linchangyi1/LocoMan/source/LocoMan_appendix.pdf

APPENDIX

A. Joint Limits of Loco-Manipulator
The range of motion for loco-manipulator’s joints is illustrated in Fig. 12, with angles of 280°, 210°, and 360° for the first through the final joint, respectively.
The motion limitation of the first joint arises from a collision between the first servo and the support structure that is part of the outer calf connector (Fig. 2). This support structure is designed primarily to connect to the opposite horn of the first servo, playing a vital role in stabilizing the manipulator. The design of the support structure aims to minimize its impact on the essential range of motion of the first servo. This critical range is necessary for extending the gripper during transitions from locomotion to manipulation and for positioning the gripper forwards and towards the ground, representing the primary workspace. The limitations in the motion of the second joint are due to self-collision. For the third joint, it does not face stringent motion restrictions, except for those imposed by the cable’s length.

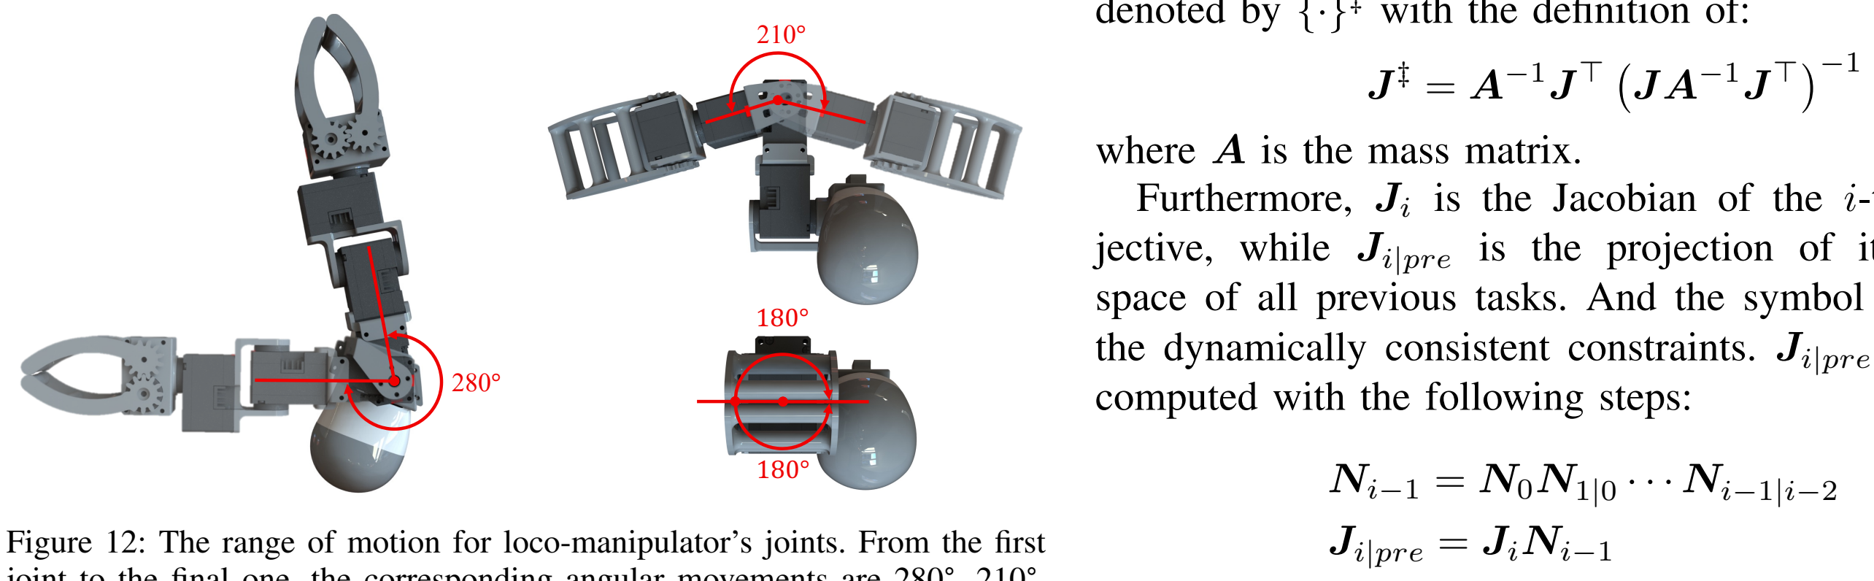
[picture p8: figure]
where A is the mass matrix. Furthermore, Ji; computed with the following steps:; Ji|pre = JiNi−1

Figure 12: The range of motion for loco-manipulator’s joints. From the first joint to the final one, the corresponding angular movements are 280°, 210°, and 360° respectively.

B. Whole-Body Impulse Control
Notation from IV: robot state q = (x

torso
, qj ) ∈ R

24, where
x

torso ∈ R

6 denotes the position and orientation of the floating torso, and qj ∈ R

18 denotes the joint angles of LocoMan. The bar notation (·) denotes all desired states.
1) Hierarchical Objective Tracking: As depicted in Table III, there are n tracking objectives in different operation modes, comprising n tracking tasks to be executed. The null space projection technique is utilized to track each objective in hierarchical order (from 1-st to n-th).
In the i-th (i = 1, ..., n) task, the tracking items consist of the desired position xi

, velocity x˙ i

, and acceleration x¨i of
the i-th tracking objective, which are tracked by computing the desired position qi

, velocity q˙
i

, and acceleration q¨i
for
both the floating torso and the joints. The desired states (qn, q˙n, and q¨n) for the last tracking objective would be the final desired states (q, q˙, and q¨) of LocoMan.

qi = qi−1 + Ji|pre

†
(xi − xi − Ji (qi−1 − q))

q˙i = q˙i−1 + Ji|pre

†
x˙ i − Jiq˙i−1

q¨i = J

dyn
i|pre

‡
x¨

cmd

i − J˙ iq˙ − Jiq¨i−1

(1)

The acceleration command x¨

cmd
i

is computed by:

x¨

cmd
i = x¨i + Kacc p

(xi − xi) + Kacc
d
x˙ i − x˙ i
(2)
where Kacc
p

and Kacc
| d

denote position and velocity feedback gains.
To compute the desired states of LocoMan from the tracking objective, we need to use the pseudo-inverse of the Jacobian. In Equation (1), we track the desired position and velocity kinematically, and the desired acceleration dynamically. Therefore, two types of pseudo-inverses are utilized. One is the SVD-based pseudo-inverse denoted by {·}†
, whcih is defined
as:
J = UΣV

T

J

† = V Σ†U
T

(3)

where J is the Jacobian and U and V are the orthogonal matrices. Besides, Σ is the diagonal matrix, and Σ†
is formed
by taking the reciprocal of each non-zero element on the diagonal of Σ, leaving the zeros in place, and then transposing the matrix.
The other is the dynamically consistent pseudo-inverse denoted by {·}‡ with the definition of:

(4)

is the Jacobian of the i-th tracking objective, while Ji|pre is the projection of it into the null space of all previous tasks. And the symbol {·}dyn denotes the dynamically consistent constraints. Ji|pre and J

dyn
i|pre

are

Ji|i−1 = Ji

I − Ji−1

†Ji−1

Ni|i−1 = I − Ji|i−1

†Ji|i−1

N

dyn
i−1 = N

dyn
0 N

dyn
| 1|0
- · · N

dyn
i−1|i−2
J

dyn

i|pre = JiN | dyn
| i−1
J

dyn
i|i−1 = Ji
I − Ji−1

‡Ji−1

N

dyn
i|i−1 = I − J
| dyn
| i|i−1

‡
J

dyn
i|i−1

(5)

where Ni−1, Ji|i−1, and Ni|i−1 represent the null space of the previous (i − 1) tasks, the projection of the Jacobian Ji into the null space of the (i − 1)-th task, and the independent null space introduced by the i-th task.
Here, i is within the range of 1, ..., n. And the initial items are defined as:
N0 = I − Jc

†Jc

N

dyn
0 = I − Jc

‡Jc

J0 = Jc
q0 = q
q˙0 = 0

q¨0 = Jc

| ‡
| (−Jcq˙)

(6)

where Jc is the Jacobian of the feet in contact.

2) Quadratic Programming: With the desired acceleration q¨ computed in the previous step, we solve a Quadratic Program (QP) to optimize for ground reaction forces. The QP problem is formulated as:

min
fr,δt

f

⊤
r Q1fr + δ

⊤
t Q2δt | (7)

s.t. Sf (Aq¨

cmd + b + g) = SfJ

⊤
c

fr (floating torso dyn.)

q¨

cmd = q¨ +

δt
0j
(floating torso acceleration)
Wfr ≥ 0 | (contact force constraints)

where the optimization objective is to minimize the reaction force fr and the relaxation variable δt for the floating torso acceleration with the weights Q1 and Q2. Sf , A, b, g, and W are the floating torso selection matrix, the mass matrix, the Coriolis force, the gravitation force, and the force constraint matrix for foot contact, respectively.
With the optimized reaction force fr and relaxation variable δt for the floating torso acceleration, we compute the joint torque command with the multi-body dynamics formulation:
τt
τj
= Aq¨

cmd + b + g − J

⊤
c
fr | (8)

where τj is the torque command for LocoMan’s joints.
3) Joint-Level PD Control: We compute the desired position qj , velocity q˙j , and torque τj for LocoMan’s joints in the previous steps, which runs in 400Hz. The final torque command τj applied to each joint is computed by a joint-level PD controller that runs in 2000Hz:

τj = τj + Ktau
p

(qj − qi) + Ktau
d
q˙j − q˙i
(9)

The high frequency joint-level PD feedback enables the robot

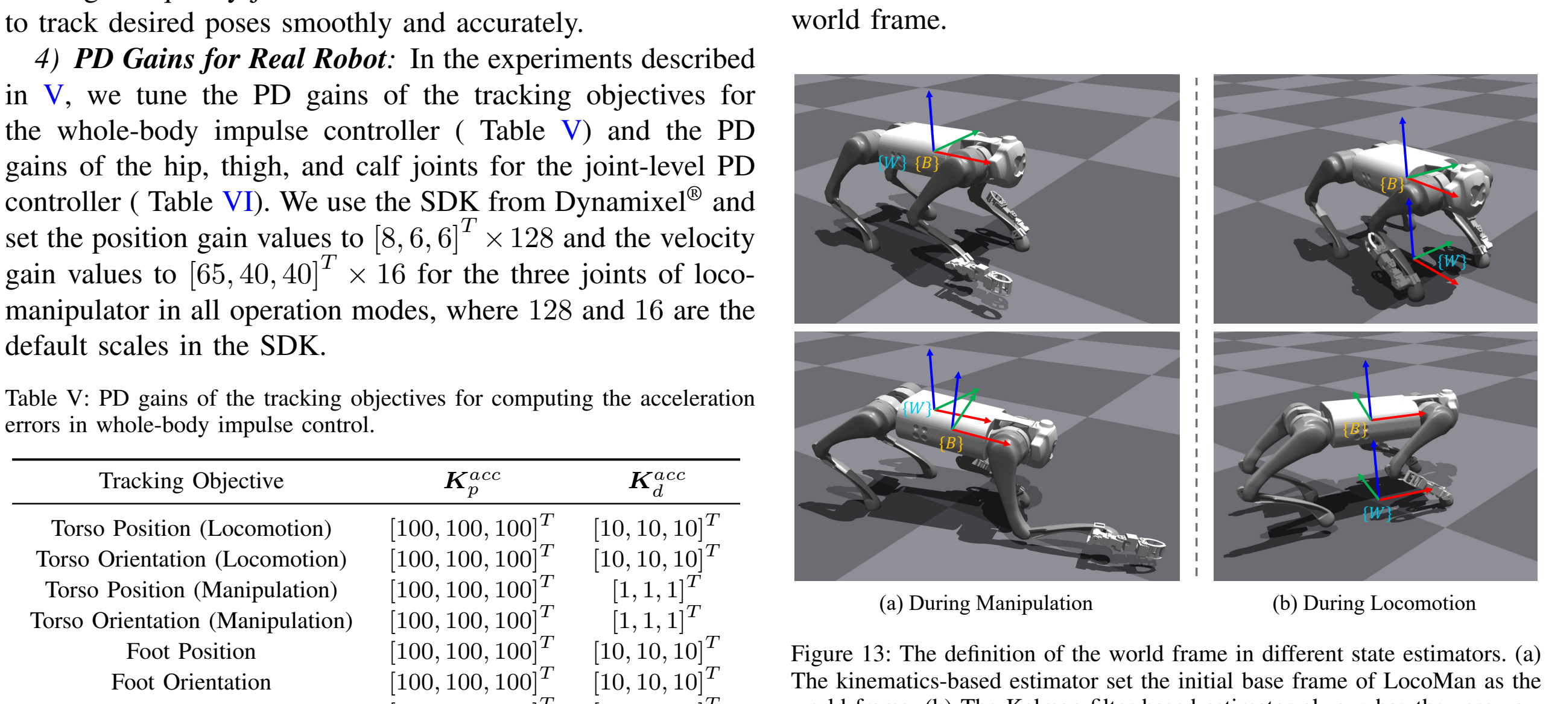
[picture p9: figure]
×128 and the velocity × 16 for the three joints of loco-; default scales in the SDK.; errors in whole-body impulse control.; Tracking Objective; Kacc; Torso Position (Locomotion); Torso Orientation (Locomotion); Torso Position (Manipulation); Torso Orientation (Manipulation); Foot Position; Foot Orientation; world frame.

to track desired poses smoothly and accurately.
4) PD Gains for Real Robot: In the experiments described in V, we tune the PD gains of the tracking objectives for the whole-body impulse controller ( Table V) and the PD gains of the hip, thigh, and calf joints for the joint-level PD controller ( Table VI). We use the SDK from Dynamixel® and set the position gain values to [8, 6, 6]T
gain values to [65, 40, 40]T
manipulator in all operation modes, where 128 and 16 are the

Table V: PD gains of the tracking objectives for computing the acceleration

Gripper Position | [100, 100, 100]T

[10, 10, 10]T
Gripper Orientation | [100, 100, 100]T

[10, 10, 10]T

Table VI: PD gains of the hip, thigh, and calf joints for computing the applied torque in joint-level PD control.

Leg Mode | Ktau
p | Ktau
d
Stance Legs in Locomotion | [30, 30, 30]T

[1, 1, 1]T
Swing Legs in Locomotion | [30, 30, 30]T

[1, 1, 1]T
Stance Legs in Loco-Manipulation [30, 30, 30]T

[1, 1, 1]T
Swing Legs in Loco-Manipulation [20, 20, 20]T

[0.8, 0.8, 0.8]T
Stance Legs in Single-Arm Manipulation [60, 60, 60]T

[2, 2, 2]T
Swing Legs in Single-Arm Manipulation [60, 60, 60]T

[2, 2, 2]T
Stance Legs in Bimanual Manipulation [100, 100, 100]T

[2.5, 2.5, 2.5]T
Swing Legs in Bimanual Manipulation [30, 30, 30]T

[1, 1, 1]T

C. State Estimation
As illustrated in Table III, there are two state estimators in our system, including the kinematics-based estimator used in the manipulation modes and the Kalman filter-based estimator used in the locomotion mode and the loco-manipulation mode. As depicted in Fig. 13 (a), at the moment when LocoMan finishes the transition process from other operation modes to manipulation modes, the kinematics-based estimator sets the base frame of LocoMan as the world frame. Furthermore, we also record the positions of the contact foot as P W
init,
which can be computed using forward kinematics and have the same values in the world frame or the base frame at the reset moment. During manipulation, the world frame remains fixed, and we compute the current positions of the contact foot in the base frame as P

B
cur. Assuming that there is no slip occurring between the contact foot and the ground, we employ the Procrustes analysis method to solve the transform matrix from the world frame to the base frame T

B
W .
As for locomotion, we implement the Kalman filter-based estimator which fuses the IMU information. As Fig. 13 (b) shows, the world frame is always updated to be the zero-yaw
(a) During Manipulation | (b) During Locomotion

Figure 13: The definition of the world frame in different state estimators. (a) The kinematics-based estimator set the initial base frame of LocoMan as the world frame. (b) The Kalman filter-based estimator always has the zero-yaw world frame as the world frame.
