linchangyi1/LocoMan/LocoMan_Hardware/assembly/loco-manipulator_right.SLDASM

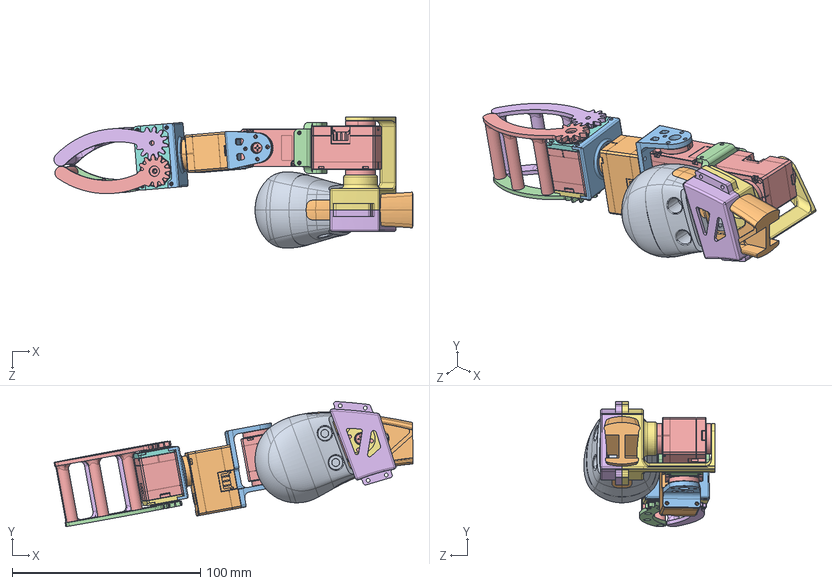
[picture p10: CAD file, 2024-10-17]
LocoMan_Hardware/assembly/loco-manipulator_right.SLDASM
190.7 x 66.4 x 69.8 mm
calf_connector_right_outside
calf_connector_right_inside
servo_double x 3
joint_connector_1
joint_connector_2
servo_single
bearing x 2
bearing_holder_1
bearing_holder_2
jaw_bearing
jaw_negative_horn
jaw_positive_horn
joint_connector_3
go1_calf_right
go1_foot_right
