linchangyi1/LocoMan/LocoMan_Hardware/Loco-Manipulators_URDF/loco_manipulator_left/loco_manipulator_left.SLDASM

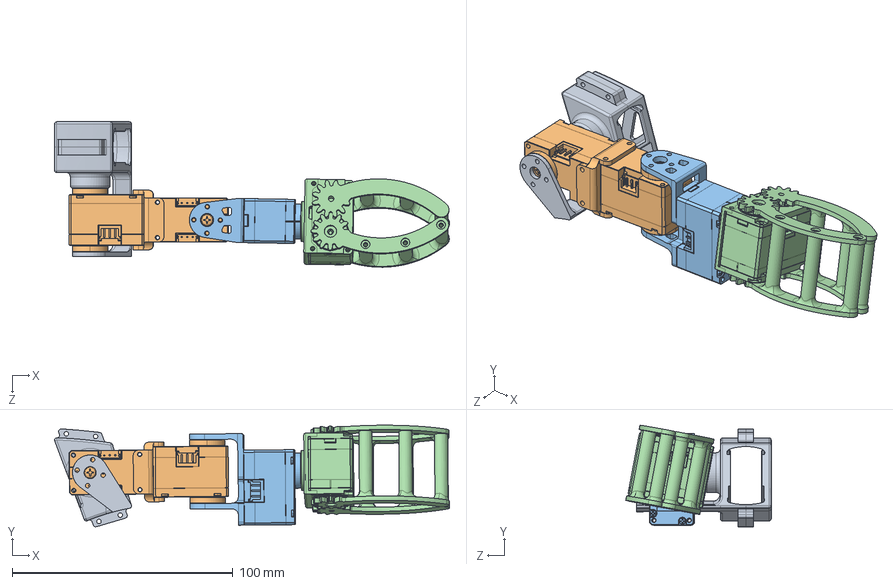
[picture p11: CAD file, 2024-10-17]
LocoMan_Hardware/Loco-Manipulators_URDF/loco_manipulator_left/loco_manipulator_left.SLDASM
178.9 x 46.0 x 65.9 mm
left_link_1
left_link_2
left_link_3
left_eef
