linchangyi1/LocoMan/LocoMan_Hardware/Loco-Manipulators_URDF/loco_manipulator_right/loco_manipulator_right.SLDASM

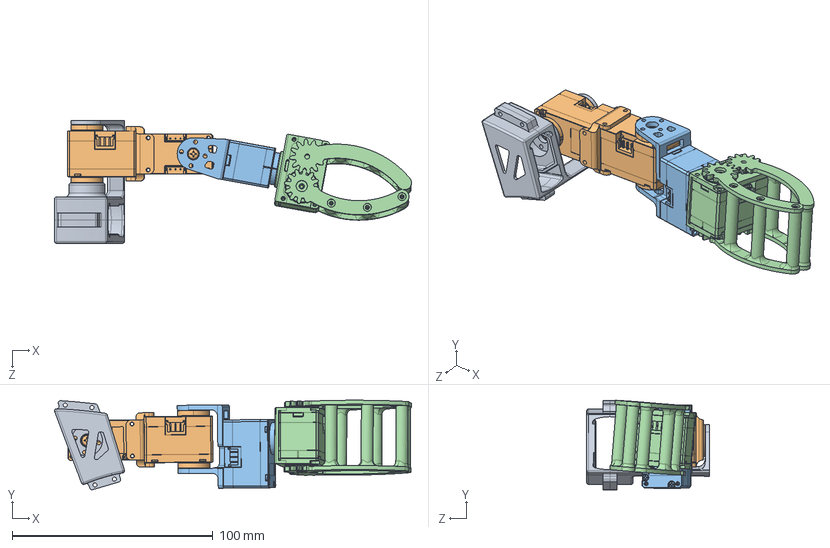
[picture p13: CAD file, 2024-10-17]
LocoMan_Hardware/Loco-Manipulators_URDF/loco_manipulator_right/loco_manipulator_right.SLDASM
177.7 x 44.6 x 61.0 mm
right_link_1
right_link_2
right_link_3
right_eef
