linchangyi1/LocoMan/LocoMan_Hardware/assembly/link_1_left.SLDASM

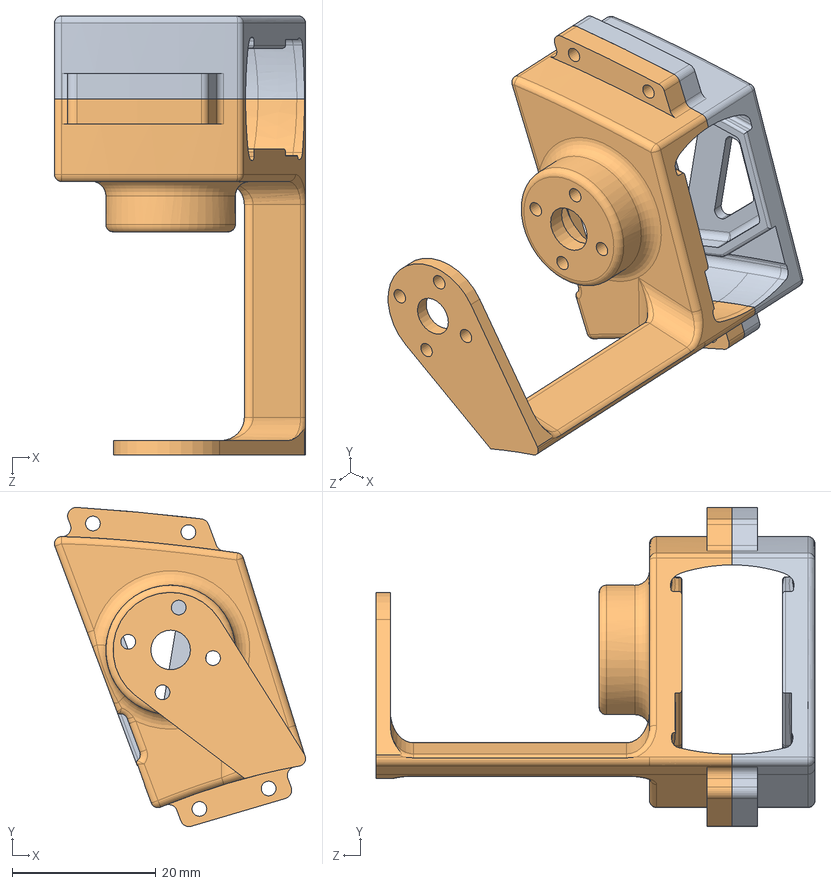
[picture p14: CAD file, 2024-10-17]
LocoMan_Hardware/assembly/link_1_left.SLDASM
34.9 x 44.3 x 61.0 mm
calf_connector_left_outside
calf_connector_left_inside
