linchangyi1/LocoMan/LocoMan_Hardware/assembly/link_3.SLDASM

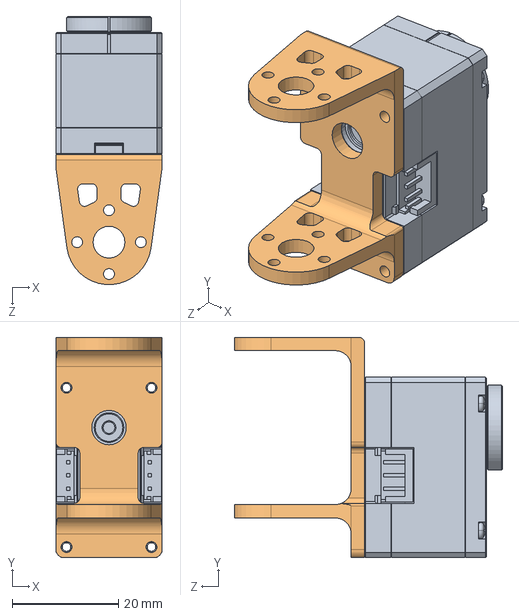
[picture p15: CAD file, 2024-10-17]
LocoMan_Hardware/assembly/link_3.SLDASM
20.0 x 41.5 x 50.5 mm
joint_connector_2
servo_single
