linchangyi1/LocoMan/LocoMan_Hardware/assembly/calf_left.SLDASM

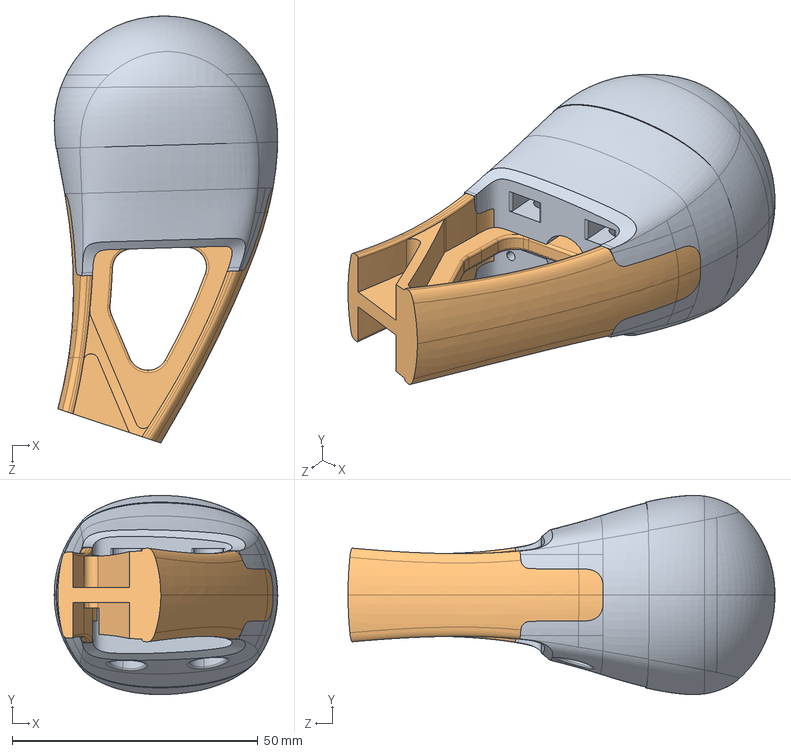
[picture p16: CAD file, 2024-10-17]
LocoMan_Hardware/assembly/calf_left.SLDASM
45.4 x 40.5 x 86.8 mm
go1_calf_left
go1_foot_left
