linchangyi1/LocoMan/LocoMan_Hardware/assembly/link_2_left.SLDASM

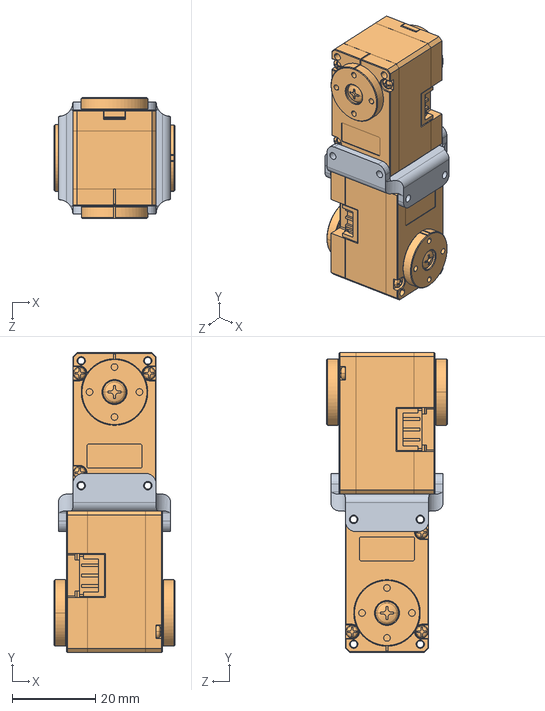
[picture p17: CAD file, 2024-10-17]
LocoMan_Hardware/assembly/link_2_left.SLDASM
29.0 x 72.1 x 29.0 mm
servo_double x 2
joint_connector_1
