linchangyi1/LocoMan/LocoMan_Hardware/assembly/gripper.SLDASM

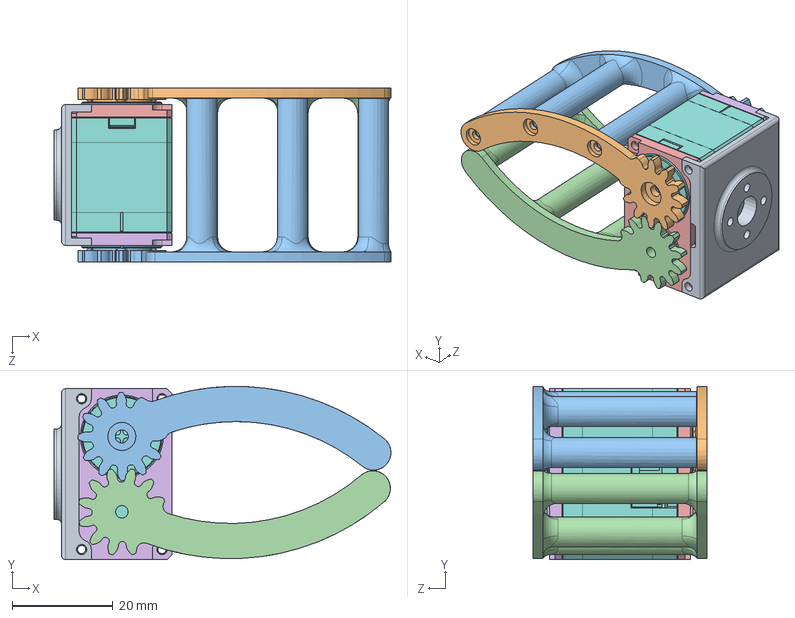
[picture p18: CAD file, 2024-10-17]
LocoMan_Hardware/assembly/gripper.SLDASM
67.1 x 34.5 x 34.6 mm
servo_double
bearing x 2
bearing_holder_1
bearing_holder_2
jaw_bearing
jaw_negative_horn
jaw_positive_horn
joint_connector_3
