linchangyi1/LocoMan/LocoMan_Hardware/part/go1_calf_full_simplified.SLDPRT

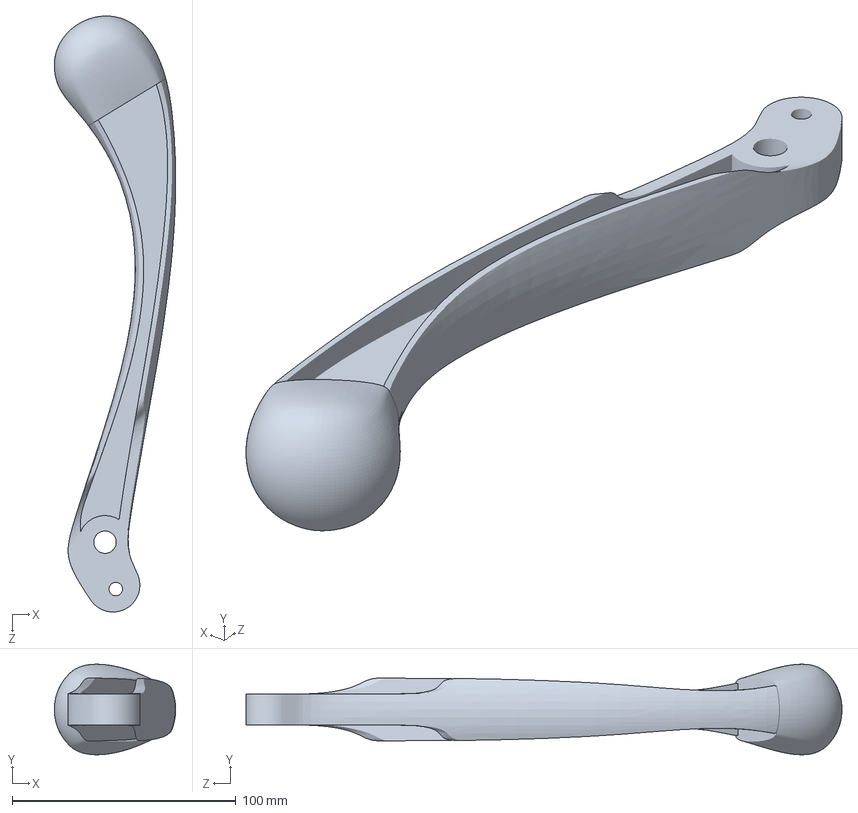
[picture p19: CAD file, 2024-10-17]
LocoMan_Hardware/part/go1_calf_full_simplified.SLDPRT
54.3 x 40.5 x 266.5 mm
