linchangyi1/LocoMan/asset/locoman/meshes/2_FL_eef.STL

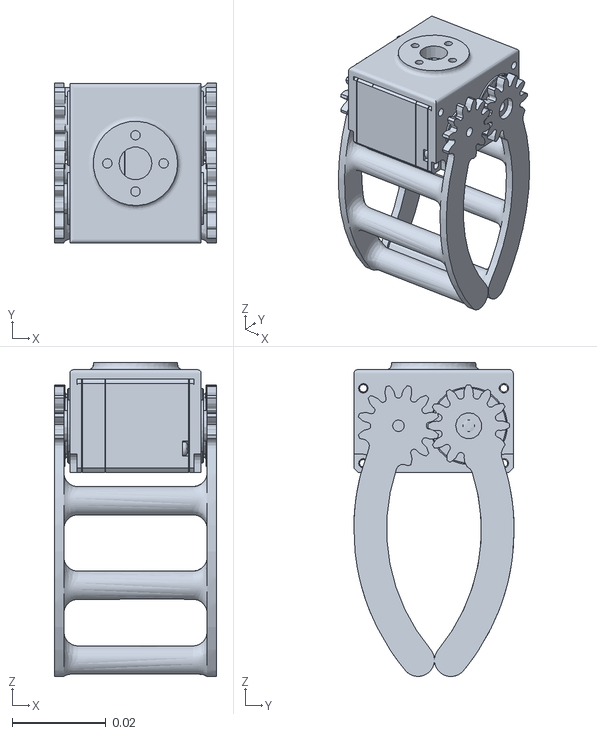
[picture p20: CAD file, 2024-09-28]
asset/locoman/meshes/2_FL_eef.STL
0.0346 x 0.0342 x 0.067
