linchangyi1/LocoMan/LocoMan_Hardware/fabrication/jaw_positive_horn.STL

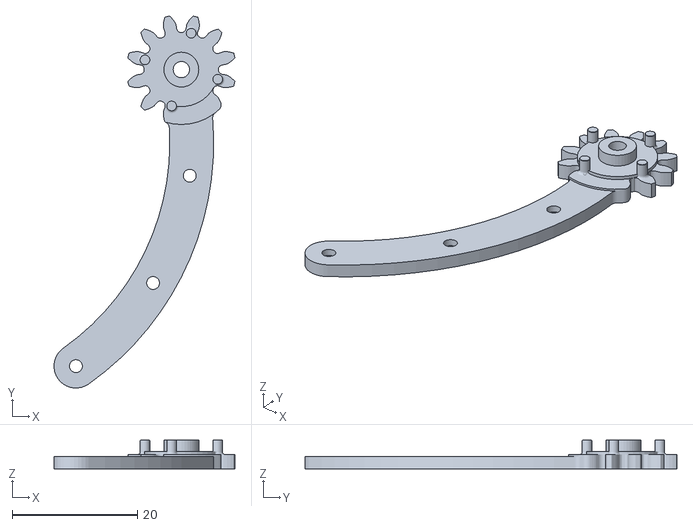
[picture p21: CAD file, 2024-10-17]
LocoMan_Hardware/fabrication/jaw_positive_horn.STL
28.8 x 59.3 x 4.60
