linchangyi1/LocoMan/LocoMan_Hardware/Loco-Manipulators_URDF/go1_reference/go1_right_leg.SLDPRT

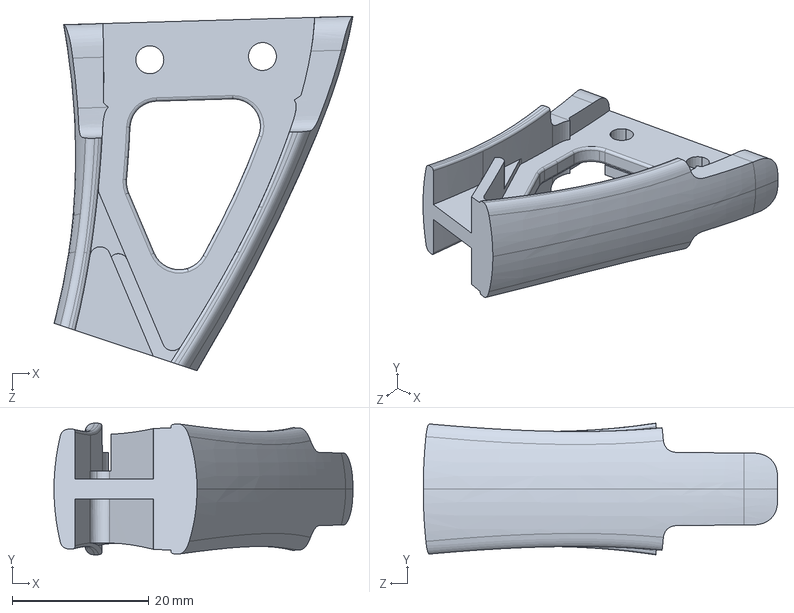
[picture p22: CAD file, 2024-10-17]
LocoMan_Hardware/Loco-Manipulators_URDF/go1_reference/go1_right_leg.SLDPRT
43.8 x 19.3 x 51.9 mm
