linchangyi1/LocoMan/LocoMan_Hardware/part/bearing.SLDPRT

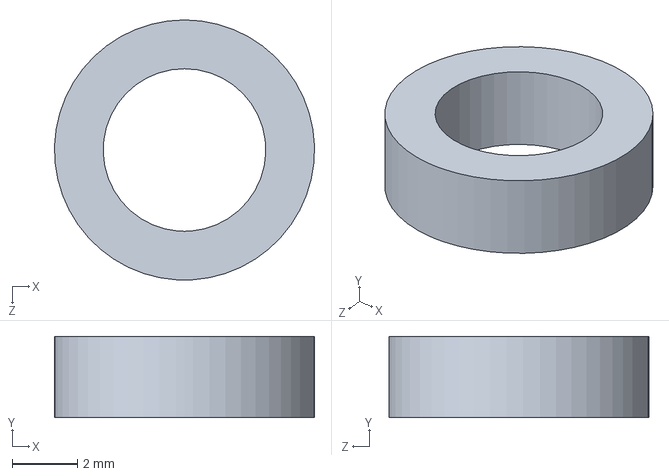
[picture p23: CAD file, 2024-10-17]
LocoMan_Hardware/part/bearing.SLDPRT
8.00 x 2.50 x 8.00 mm
