linchangyi1/LocoMan/asset/locoman/meshes/hip.stl

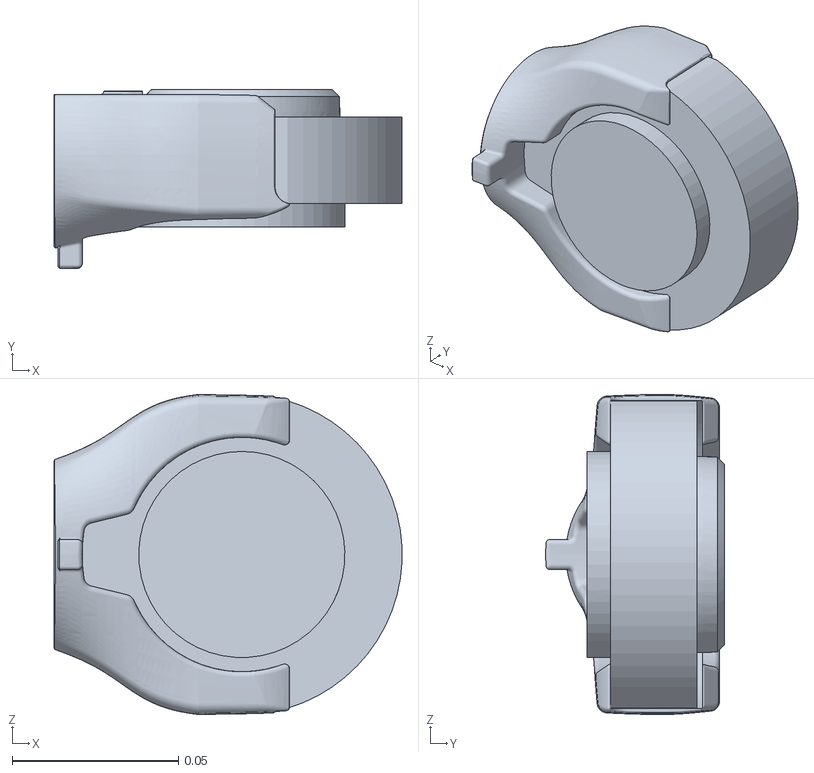
[picture p24: CAD file, 2024-09-28]
asset/locoman/meshes/hip.stl
0.105 x 0.0538 x 0.0963
