linchangyi1/LocoMan/LocoMan_Hardware/fabrication/bearing_holder_1.STL

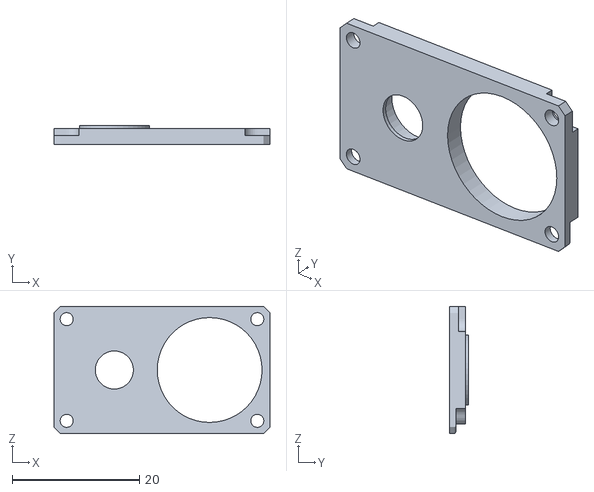
[picture p25: CAD file, 2024-10-17]
LocoMan_Hardware/fabrication/bearing_holder_1.STL
34.0 x 3.00 x 20.0
