linchangyi1/LocoMan/LocoMan_Hardware/part/calf_connector_left_outside.SLDPRT

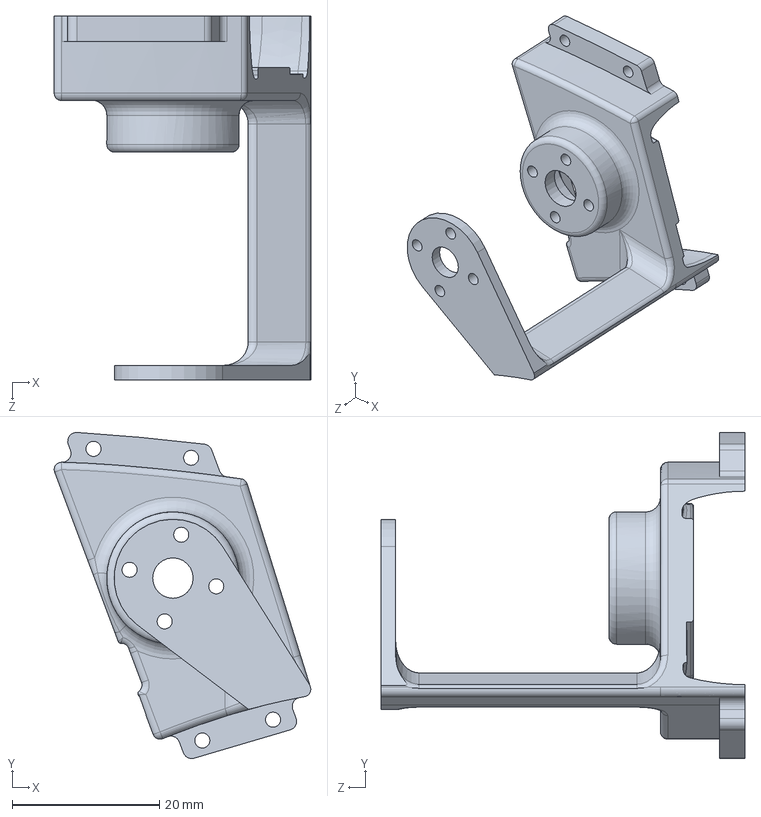
[picture p26: CAD file, 2024-10-17]
LocoMan_Hardware/part/calf_connector_left_outside.SLDPRT
34.9 x 44.3 x 49.5 mm
