linchangyi1/LocoMan/asset/locoman/meshes/1_FR_link_1.STL

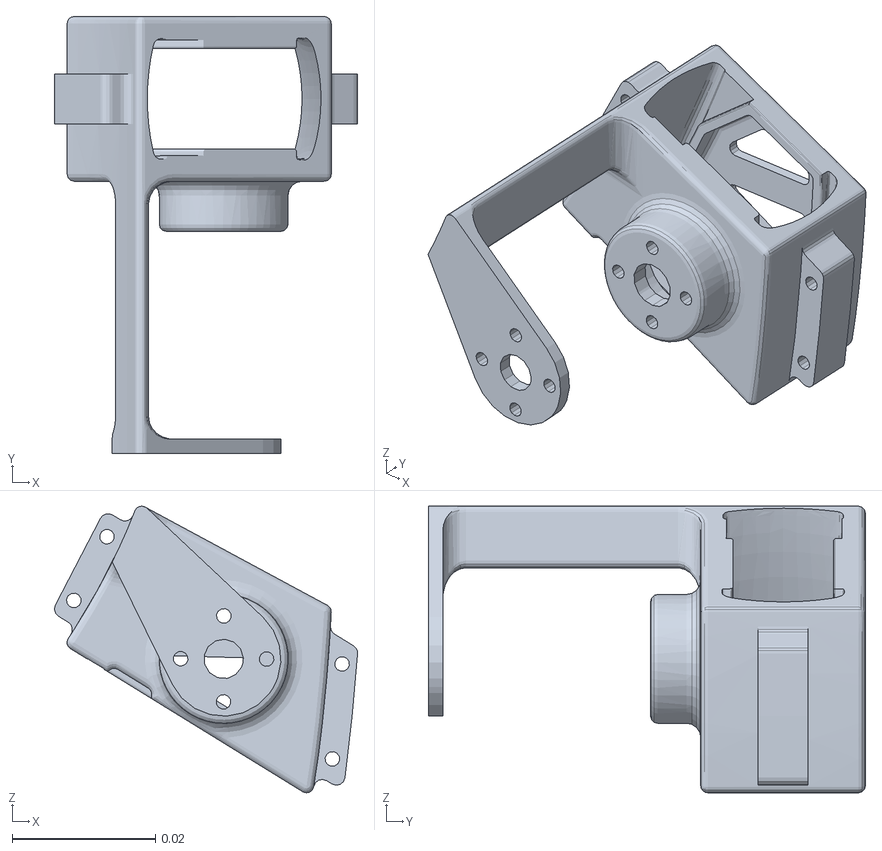
[picture p27: CAD file, 2024-09-28]
asset/locoman/meshes/1_FR_link_1.STL
0.0423 x 0.061 x 0.04
