linchangyi1/LocoMan/LocoMan_Hardware/fabrication/jaw_negative_horn.STL

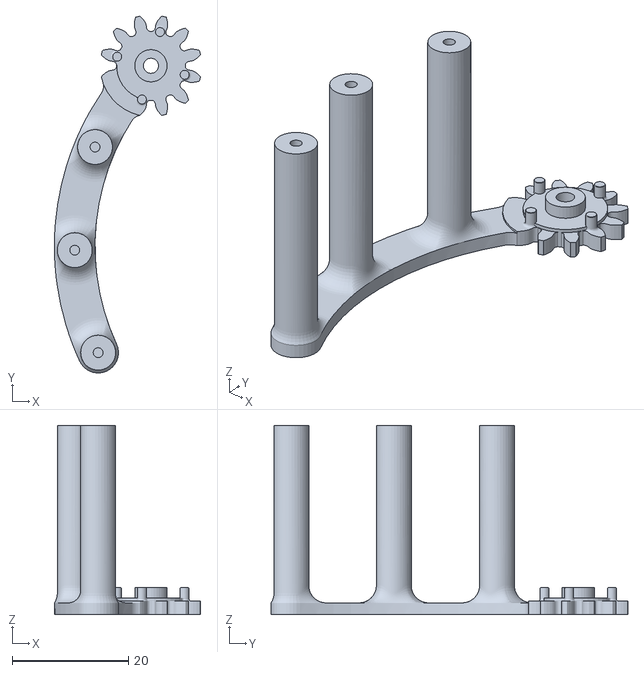
[picture p28: CAD file, 2024-10-17]
LocoMan_Hardware/fabrication/jaw_negative_horn.STL
25.1 x 61.4 x 32.5
