linchangyi1/LocoMan/LocoMan_Hardware/Loco-Manipulators_URDF/go1_reference/foot_right.SLDPRT

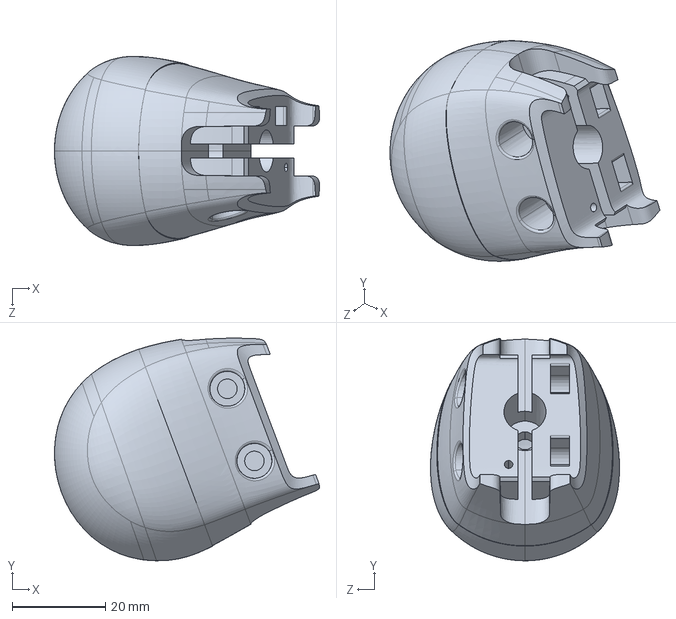
[picture p29: CAD file, 2024-10-17]
LocoMan_Hardware/Loco-Manipulators_URDF/go1_reference/foot_right.SLDPRT
56.8 x 47.7 x 40.5 mm
