linchangyi1/LocoMan/LocoMan_Hardware/part/joint_connector_3.SLDPRT

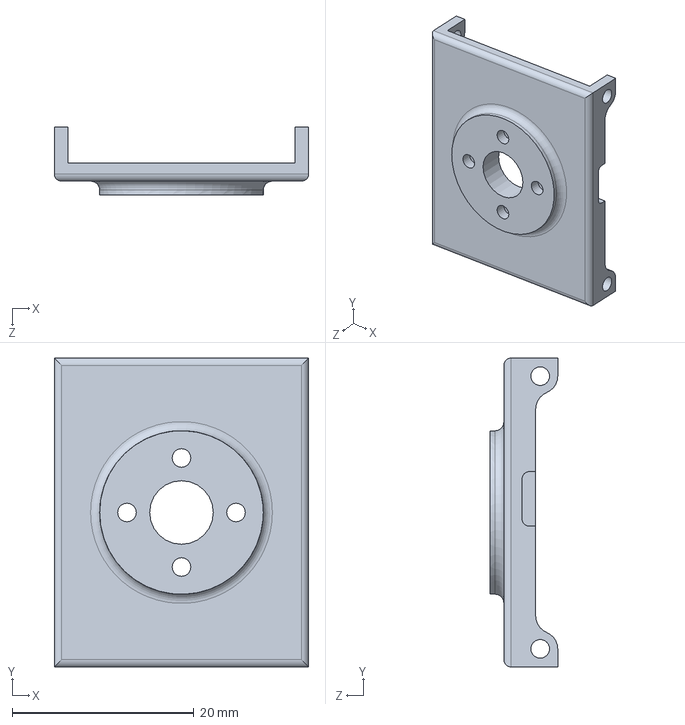
[picture p30: CAD file, 2024-10-17]
LocoMan_Hardware/part/joint_connector_3.SLDPRT
28.0 x 34.0 x 7.43 mm
