linchangyi1/LocoMan/asset/locoman/meshes/calf.stl

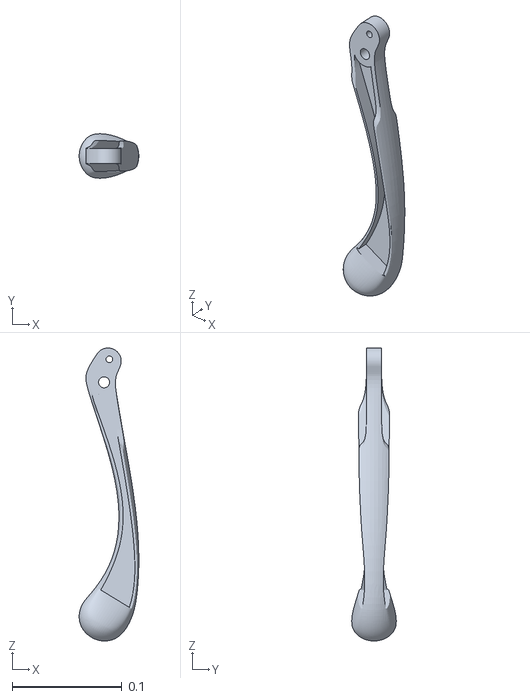
[picture p31: CAD file, 2024-09-28]
asset/locoman/meshes/calf.stl
0.0543 x 0.0405 x 0.266
