linchangyi1/LocoMan/LocoMan_Hardware/fabrication/joint_connector_2.STL

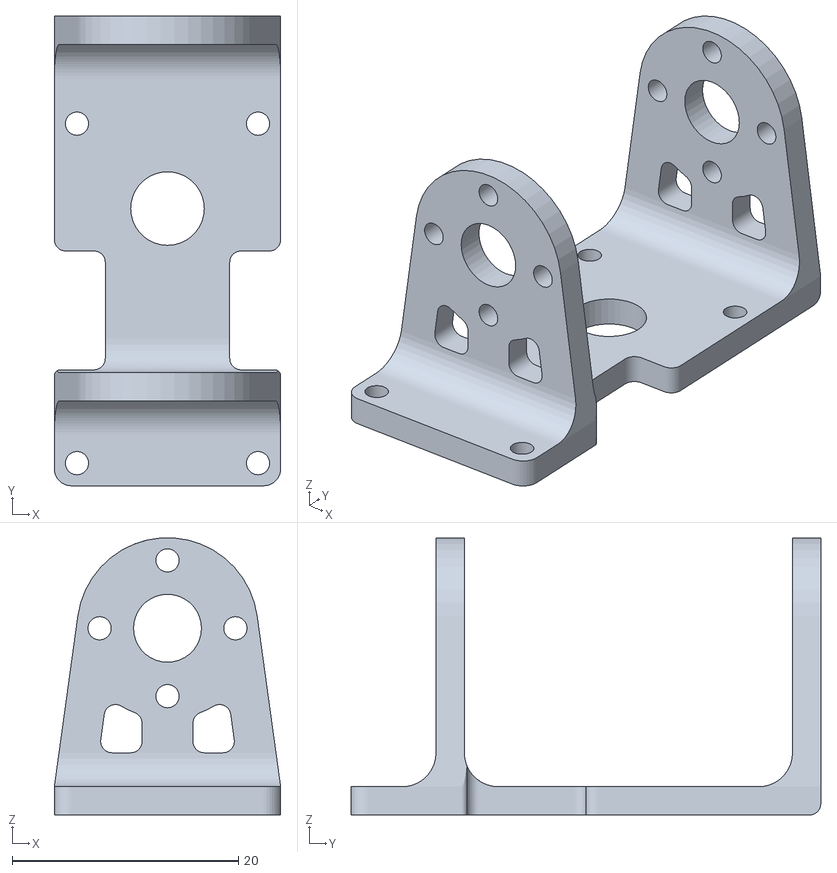
[picture p32: CAD file, 2024-10-17]
LocoMan_Hardware/fabrication/joint_connector_2.STL
20.0 x 41.5 x 24.5
