linchangyi1/LocoMan/LocoMan_Hardware/part/jaw_bearing.SLDPRT

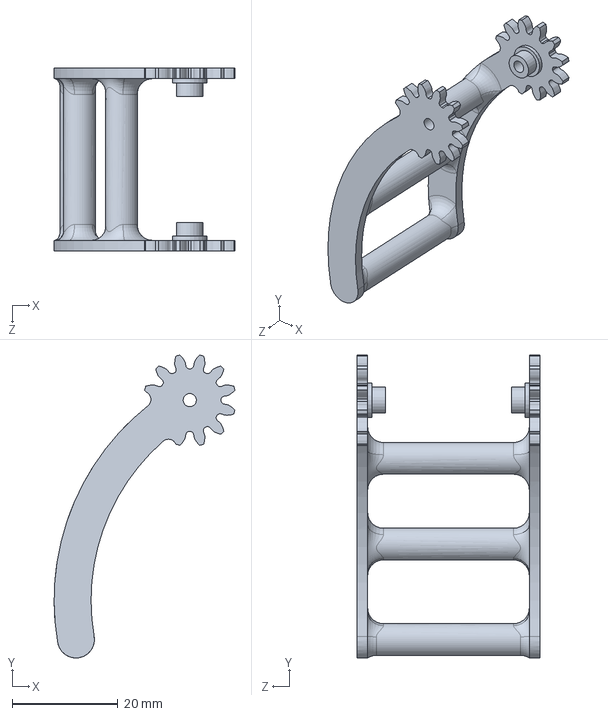
[picture p33: CAD file, 2024-10-17]
LocoMan_Hardware/part/jaw_bearing.SLDPRT
34.2 x 57.3 x 34.6 mm
