linchangyi1/LocoMan/asset/locoman/meshes/2_FL_link_2.STL

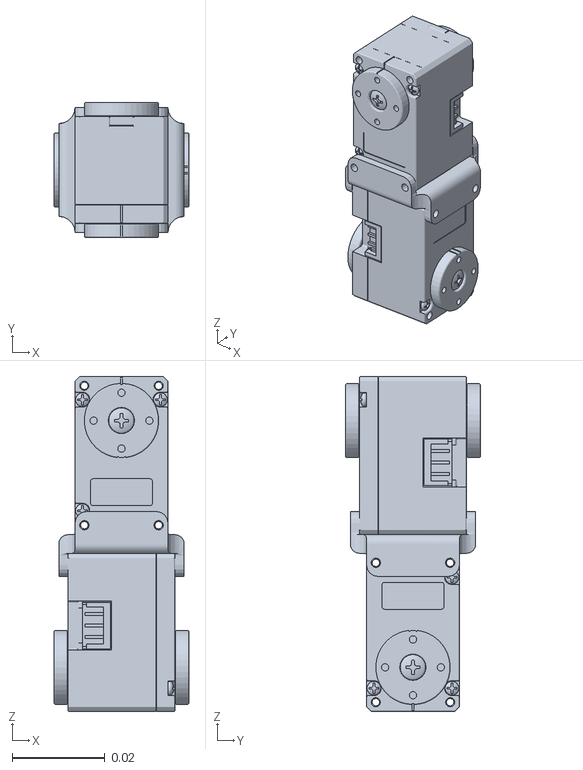
[picture p34: CAD file, 2024-09-28]
asset/locoman/meshes/2_FL_link_2.STL
0.029 x 0.029 x 0.0721
