linchangyi1/LocoMan/asset/locoman/meshes/thigh.stl

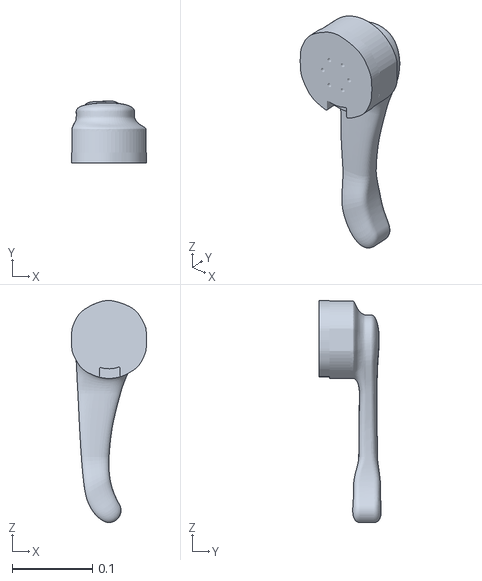
[picture p35: CAD file, 2024-09-28]
asset/locoman/meshes/thigh.stl
0.094 x 0.0779 x 0.277
