linchangyi1/LocoMan/LocoMan_Hardware/fabrication/joint_connector_1.STL

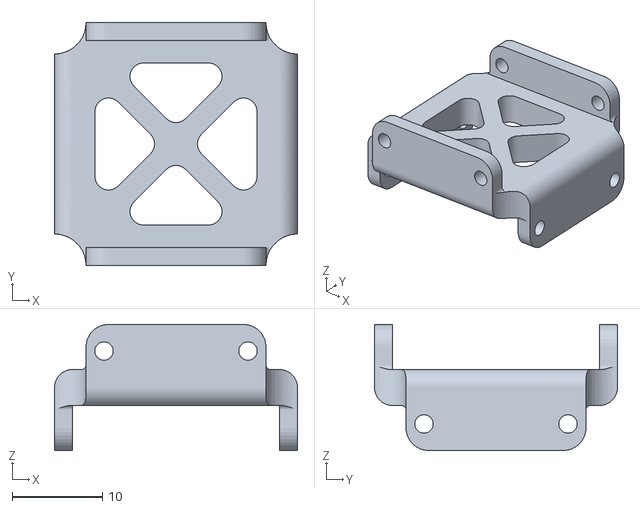
[picture p36: CAD file, 2024-10-17]
LocoMan_Hardware/fabrication/joint_connector_1.STL
27.0 x 27.0 x 14.0
