linchangyi1/LocoMan/LocoMan_Hardware/fabrication/calf_connector_right_inside.STL

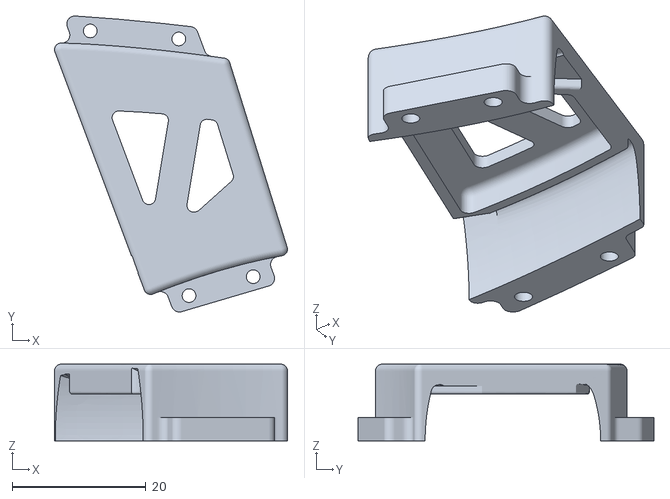
[picture p37: CAD file, 2024-10-17]
LocoMan_Hardware/fabrication/calf_connector_right_inside.STL
34.9 x 44.3 x 11.5
