linchangyi1/LocoMan/LocoMan_Hardware/part/servo_single.SLDPRT

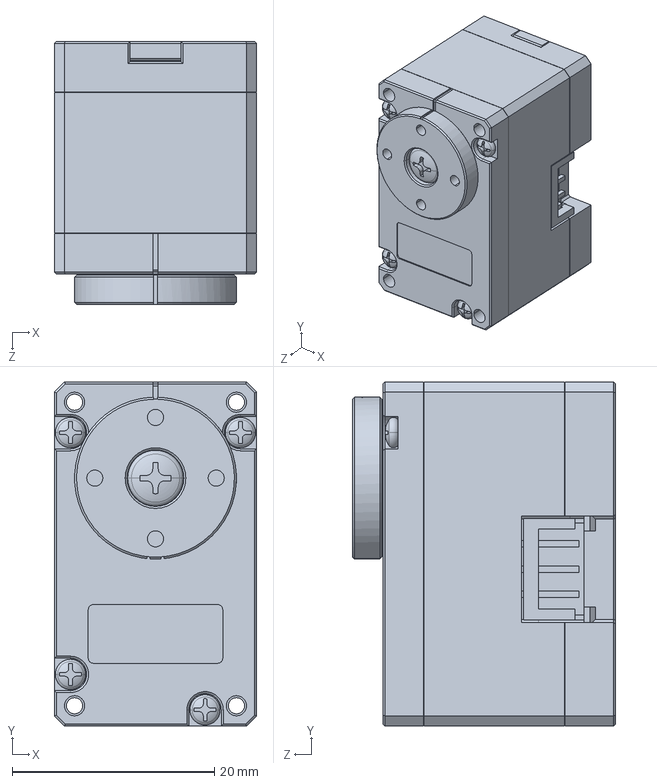
[picture p38: CAD file, 2024-10-17]
LocoMan_Hardware/part/servo_single.SLDPRT
20.0 x 34.0 x 26.0 mm
