linchangyi1/LocoMan/asset/locoman/meshes/1_FR_link_3.STL

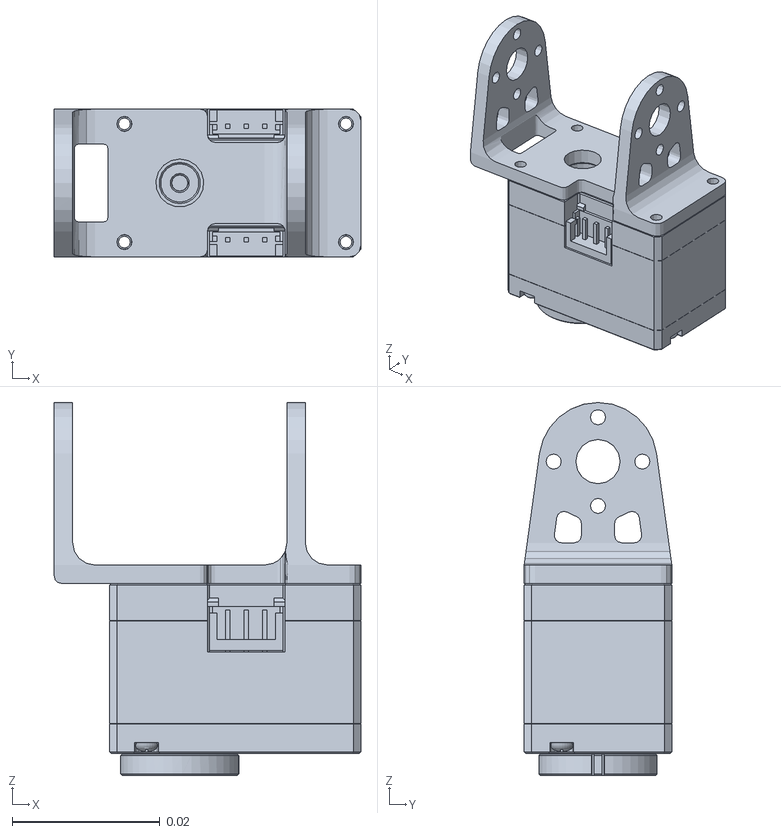
[picture p39: CAD file, 2024-09-28]
asset/locoman/meshes/1_FR_link_3.STL
0.0415 x 0.02 x 0.0505
