linchangyi1/LocoMan/asset/locoman/meshes/thigh_mirror.stl

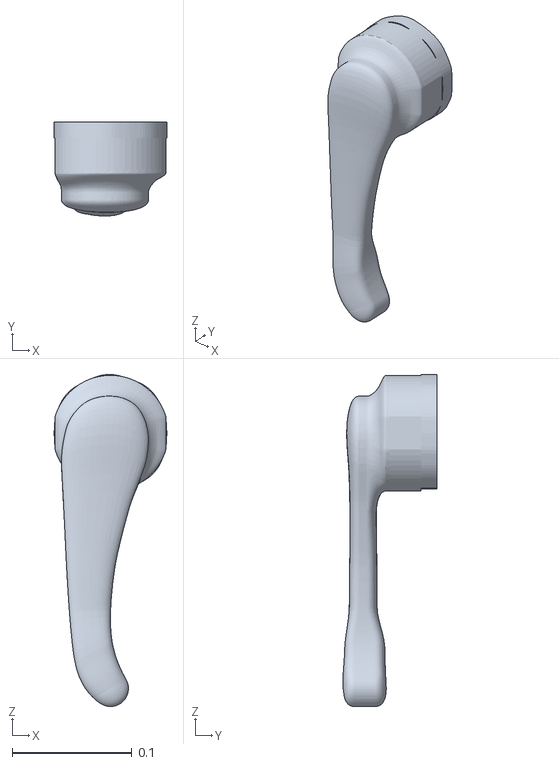
[picture p40: CAD file, 2024-09-28]
asset/locoman/meshes/thigh_mirror.stl
0.094 x 0.0784 x 0.277
