linchangyi1/LocoMan/LocoMan_Hardware/part/servo_double.SLDPRT

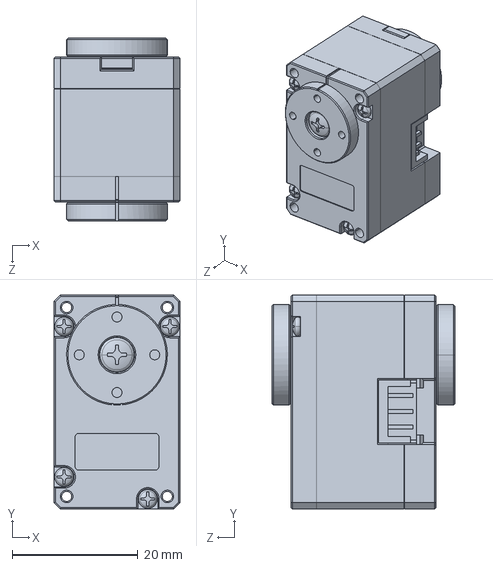
[picture p41: CAD file, 2024-10-17]
LocoMan_Hardware/part/servo_double.SLDPRT
20.0 x 34.0 x 29.0 mm
