linchangyi1/LocoMan/LocoMan_Hardware/assembly/loco-manipulator_left_urdf.SLDASM

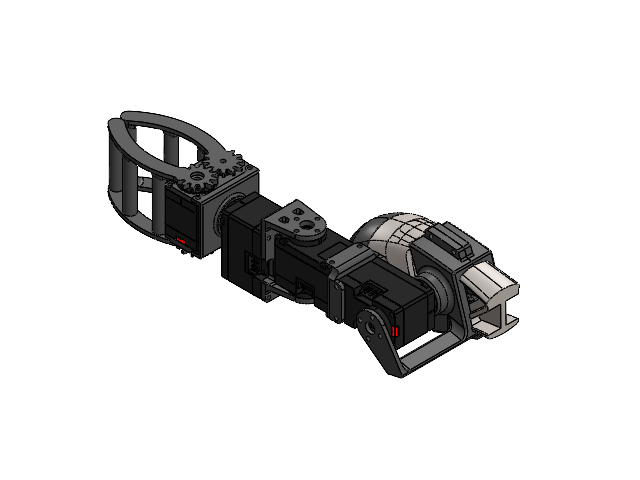
[picture p42: CAD file, 2024-10-17]
LocoMan_Hardware/assembly/loco-manipulator_left_urdf.SLDASM
link_1_left
link_2_left
link_3
gripper
calf_left
