linchangyi1/LocoMan/LocoMan_Hardware/assembly/loco-manipulator_right_urdf.SLDASM

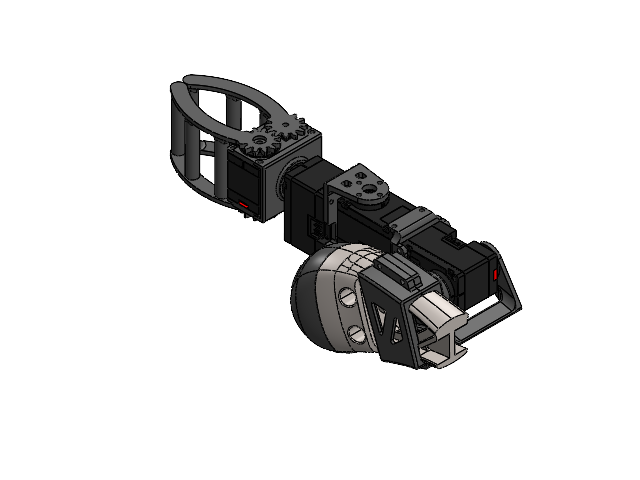
[picture p43: CAD file, 2024-10-17]
LocoMan_Hardware/assembly/loco-manipulator_right_urdf.SLDASM
link_1_right
link_2_right
link_3
gripper
calf_right
