linchangyi1/LocoMan/LocoMan_Hardware/assembly/loco-manipulator_left_fabrication.SLDASM

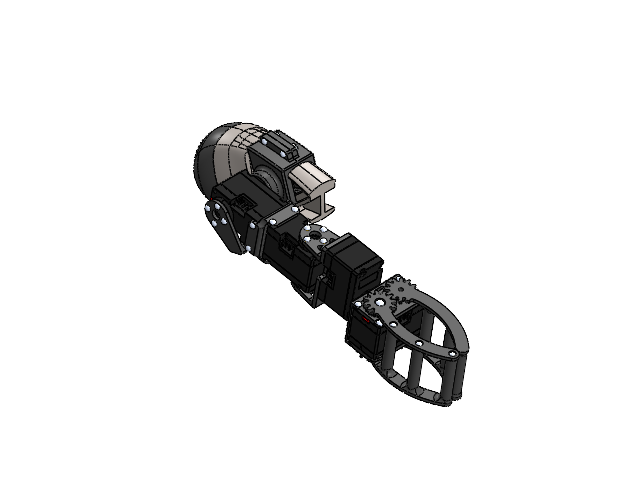
[picture p44: CAD file, 2024-10-17]
LocoMan_Hardware/assembly/loco-manipulator_left_fabrication.SLDASM
calf_connector_left_outside
calf_connector_left_inside
servo_double x 3
joint_connector_1
joint_connector_2
servo_single
bearing x 2
bearing_holder_1
bearing_holder_2
jaw_bearing
jaw_negative_horn
jaw_positive_horn
joint_connector_3
go1_calf_left
go1_foot_left
M2_4cm_screw x 11
M2_spring_washer x 12
M2_6cm_screw x 12
M2.5_spring_washer
M2.5_10cm_screw
M2.5_6cm_screw
M2_10cm_screw x 24
M2_nut x 4
