linchangyi1/LocoMan/(list of files, cad)

Other CAD files:
LocoMan_Hardware/assembly/link_1_right.SLDASM
LocoMan_Hardware/assembly/calf_right.SLDASM
LocoMan_Hardware/assembly/link_2_right.SLDASM
LocoMan_Hardware/Loco-Manipulators_URDF/loco_manipulator_left/left_link_3.SLDPRT
LocoMan_Hardware/Loco-Manipulators_URDF/loco_manipulator_right/right_link_3.SLDPRT
LocoMan_Hardware/Loco-Manipulators_URDF/loco_manipulator_right/right_link_2.SLDPRT
LocoMan_Hardware/Loco-Manipulators_URDF/loco_manipulator_left/left_link_2.SLDPRT
LocoMan_Hardware/Loco-Manipulators_URDF/loco_manipulator_left/left_eef.SLDPRT
LocoMan_Hardware/Loco-Manipulators_URDF/loco_manipulator_right/right_eef.SLDPRT
LocoMan_Hardware/fabrication/calf_connector_right_outside.STL
LocoMan_Hardware/Loco-Manipulators_URDF/loco_manipulator_left/left_link_1.SLDPRT
LocoMan_Hardware/Loco-Manipulators_URDF/loco_manipulator_right/right_link_1.SLDPRT
LocoMan_Hardware/part/joint_connector_2.SLDPRT
asset/locoman/meshes/1_FR_eef.STL
asset/locoman/meshes/2_FL_link_1.STL
LocoMan_Hardware/fabrication/bearing_holder_2.STL
LocoMan_Hardware/part/joint_connector_1.SLDPRT
asset/locoman/meshes/1_FR_link_2.STL
LocoMan_Hardware/fabrication/calf_connector_left_outside.STL
LocoMan_Hardware/fabrication/joint_connector_3.STL
LocoMan_Hardware/fabrication/jaw_bearing.STL
LocoMan_Hardware/part/jaw_negative_horn.SLDPRT
asset/locoman/meshes/2_FL_link_3.STL
LocoMan_Hardware/fabrication/calf_connector_left_inside.STL
LocoMan_Hardware/part/go1_foot_right.SLDPRT
LocoMan_Hardware/part/calf_connector_right_inside.SLDPRT
LocoMan_Hardware/part/calf_connector_right_outside.SLDPRT
LocoMan_Hardware/part/calf_connector_left_inside.SLDPRT
LocoMan_Hardware/part/go1_calf_left.SLDPRT
LocoMan_Hardware/part/bearing_holder_2.SLDPRT
LocoMan_Hardware/part/jaw_positive_horn.SLDPRT
LocoMan_Hardware/part/go1_foot_left.SLDPRT
LocoMan_Hardware/part/go1_calf_right.SLDPRT
LocoMan_Hardware/part/bearing_holder_1.SLDPRT
LocoMan_Hardware/assembly/calf_left.SLDPRT
LocoMan_Hardware/assembly/calf_right.SLDPRT
LocoMan_Hardware/assembly/gripper.SLDPRT
LocoMan_Hardware/assembly/link_1_left.SLDPRT
LocoMan_Hardware/assembly/link_1_right.SLDPRT
LocoMan_Hardware/assembly/link_2_left.SLDPRT
LocoMan_Hardware/assembly/link_2_right.SLDPRT
LocoMan_Hardware/assembly/link_3.SLDPRT
LocoMan_Hardware/part/M2.5_10cm_screw.SLDPRT
LocoMan_Hardware/part/M2.5_6cm_screw.SLDPRT
LocoMan_Hardware/part/M2.5_spring_washer.SLDPRT
LocoMan_Hardware/part/M2_10cm_screw.SLDPRT
LocoMan_Hardware/part/M2_4cm_screw.SLDPRT
LocoMan_Hardware/part/M2_6cm_screw.SLDPRT
LocoMan_Hardware/part/M2_nut.SLDPRT
LocoMan_Hardware/part/M2_spring_washer.SLDPRT
