linchangyi1/LocoMan/(threads)

Thread 1 (2025-06-10):

关于姿态误差的求解

PoplarCrystal, 2025-06-10:
很感谢您的贡献，其他WBC部分受益良多
我看到您的姿态误差求解公式为

    def _compute_orientation_error_from_two_world_rpy(self, des_rpy, actual_rpy):
        des_rot = rpy_to_rot_mat(des_rpy)
        actual_rot = rpy_to_rot_mat(actual_rpy)
        return rot_mat_to_rpy(des_rot.dot(actual_rot.T))
也就是log(Rdes * Rcur.T)
我记得还有另外一种形式是Rcur * log(Rcur.T * Rdes)
似乎这两种方法的关系是相反数，
但是我不确定哪种是更符合的

linchangyi1, 2025-06-10:
Hi,
log(R_des * R_cur.T) represents the **world**-frame error;
R_cur * log(R_cur.T * R_des) represents the **body**-frame error.
I think both are correct physically.
For LocoMan, I choose the first one since we compute all tracking objectives in the world frame.

Closed 2025-08-13.
