linchangyi1/LocoMan/(commit log)

2024-09-28 Initial commit on new branch
    [1_FR_eef.STL, 1_FR_link_1.STL, 1_FR_link_2.STL, 1_FR_link_3.STL, 2_FL_eef.STL, 2_FL_link_1.STL, 2_FL_link_2.STL, 2_FL_link_3.STL]
2024-10-17 upload locoman_hardware
    [M2.5_10cm_screw.SLDPRT, M2.5_6cm_screw.SLDPRT, M2.5_spring_washer.SLDPRT, M2_10cm_screw.SLDPRT, M2_4cm_screw.SLDPRT, M2_6cm_screw.SLDPRT, M2_nut.SLDPRT, M2_spring_washer.SLDPRT]
